jchimpo138/ear-system/research/board images/ip5310_front_components.jpg

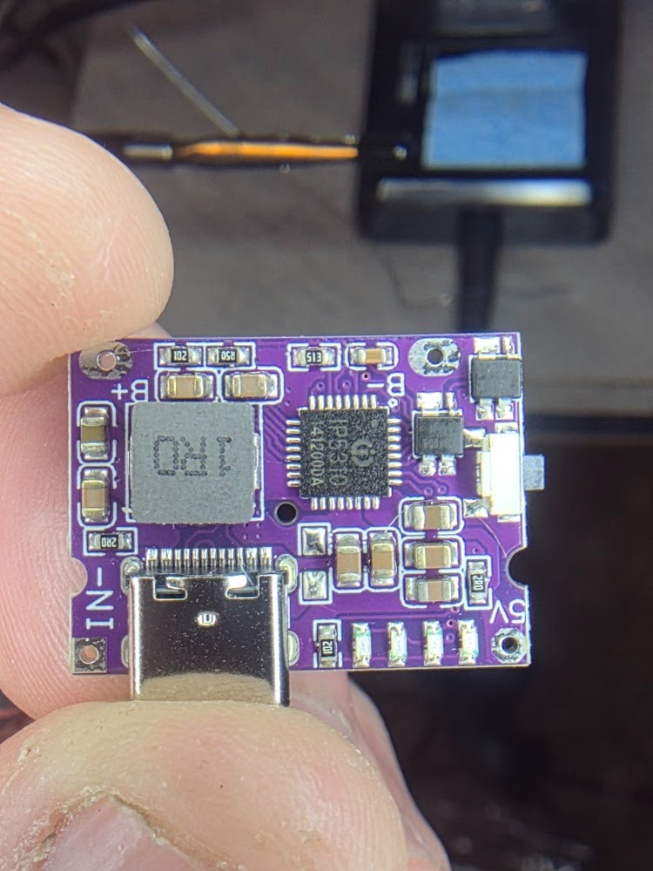
research/board images/ip5310_front_components.jpg
