jchimpo138/ear-system/.agent/rules/01-backlog-scope.md

---
trigger: always_on
---

---
trigger: always_on
description: Scope enforcement to keep focus on MVP and isolate backlog
---

# Scope & Backlog Rules

**CRITICAL SCOPE DIRECTIVE:**
1. **MVP Focus Only:** Work strictly on the current foundational/MVP requirements unless directed otherwise.
2. **Backlog Isolation:** The contents of `backlog.md` are exclusively for future roadmap planning. 
3. **NEVER IMPLEMENT BACKLOG CODE:** NEVER write, refactor, or stub code for features listed in `backlog.md` unless the active prompt explicitly instructs to pull a specific item out of the backlog.
