jchimpo138/ear-system/research/board images/FZ5vfDEWQAIqXjY.jpg

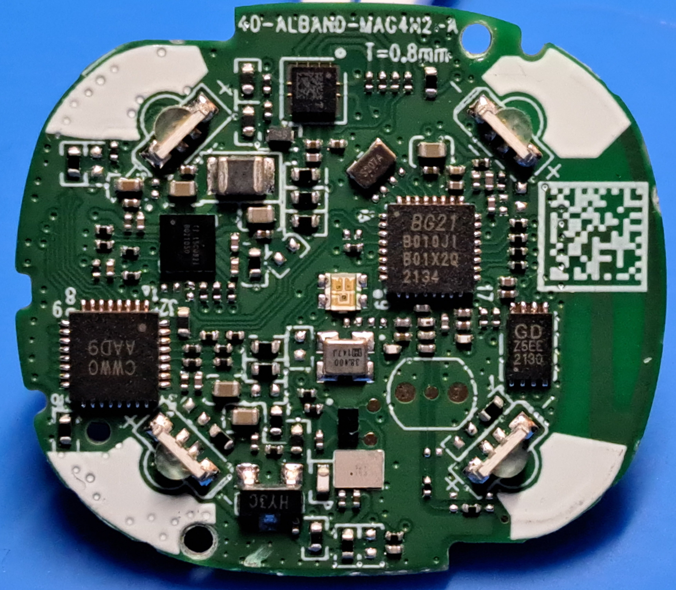
research/board images/FZ5vfDEWQAIqXjY.jpg
