jchimpo138/ear-system/research/board images/FZ5vfszXoAICueY.jpg

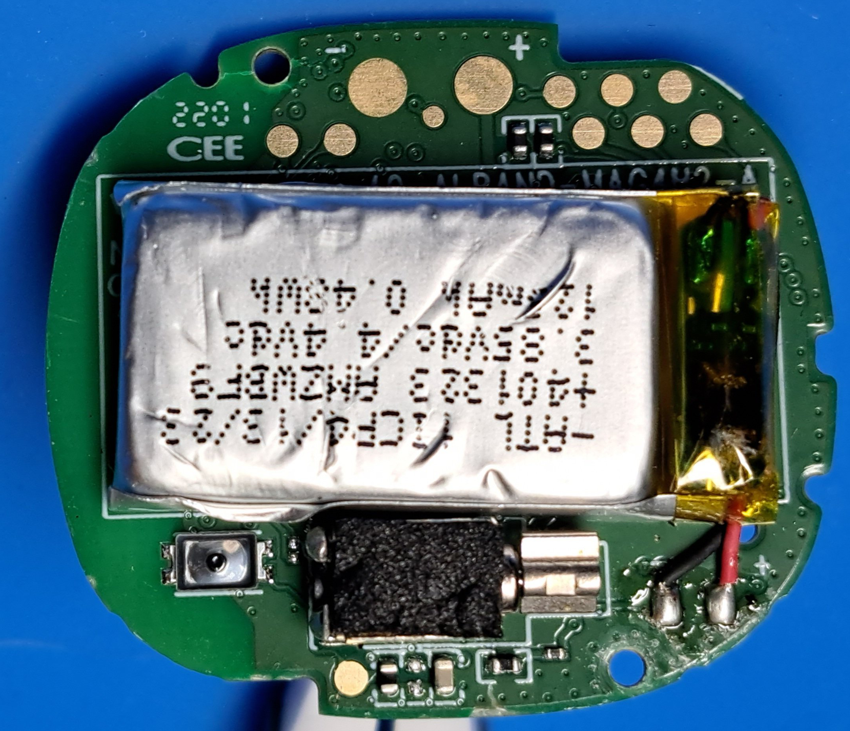
research/board images/FZ5vfszXoAICueY.jpg
