jchimpo138/ear-system/research/board images/FZ8nvv1XEAYfaYP.jpg

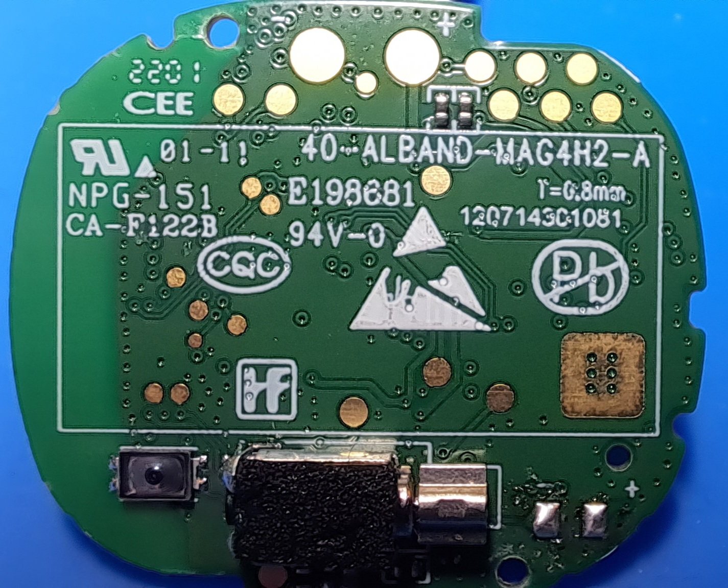
research/board images/FZ8nvv1XEAYfaYP.jpg
