jchimpo138/ear-system/research/board images/FZ8nvXFXoAEG2Y3.jpg

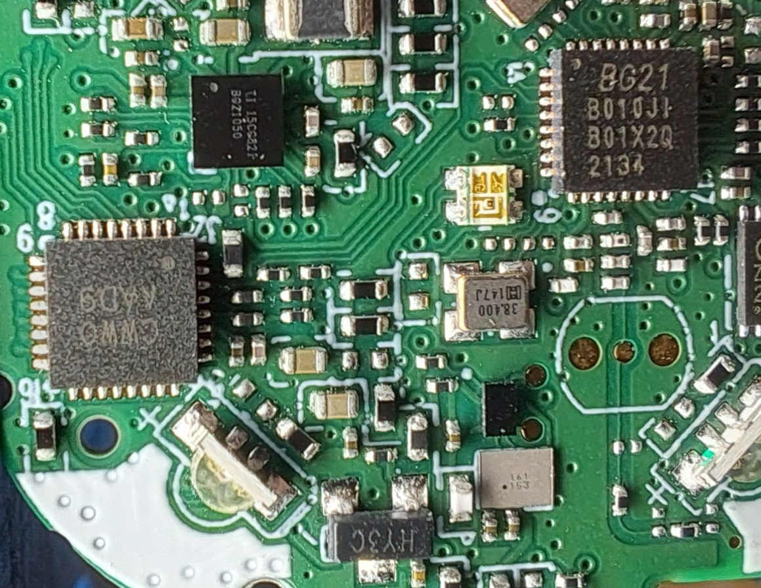
research/board images/FZ8nvXFXoAEG2Y3.jpg
