jchimpo138/ear-system/research/board images/ip5310_back_pads.jpg

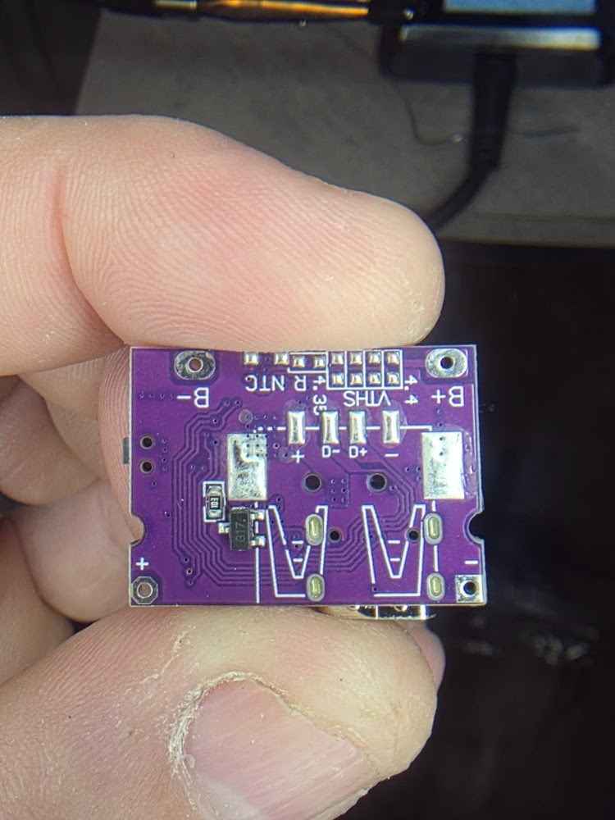
research/board images/ip5310_back_pads.jpg
