jchimpo138/ear-system/research/promicro nrf52843 v1940.jpg

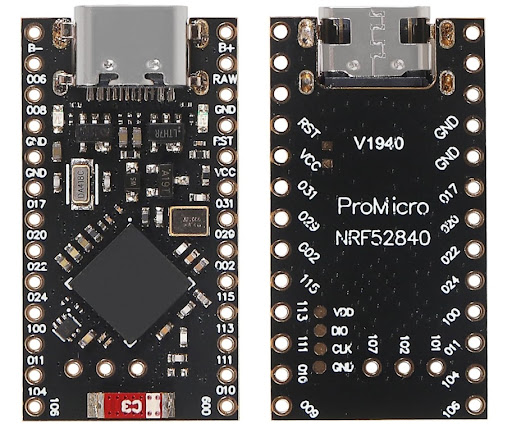
research/promicro nrf52843 v1940.jpg
