jchimpo138/ear-system/research/thor 503450 battery.png

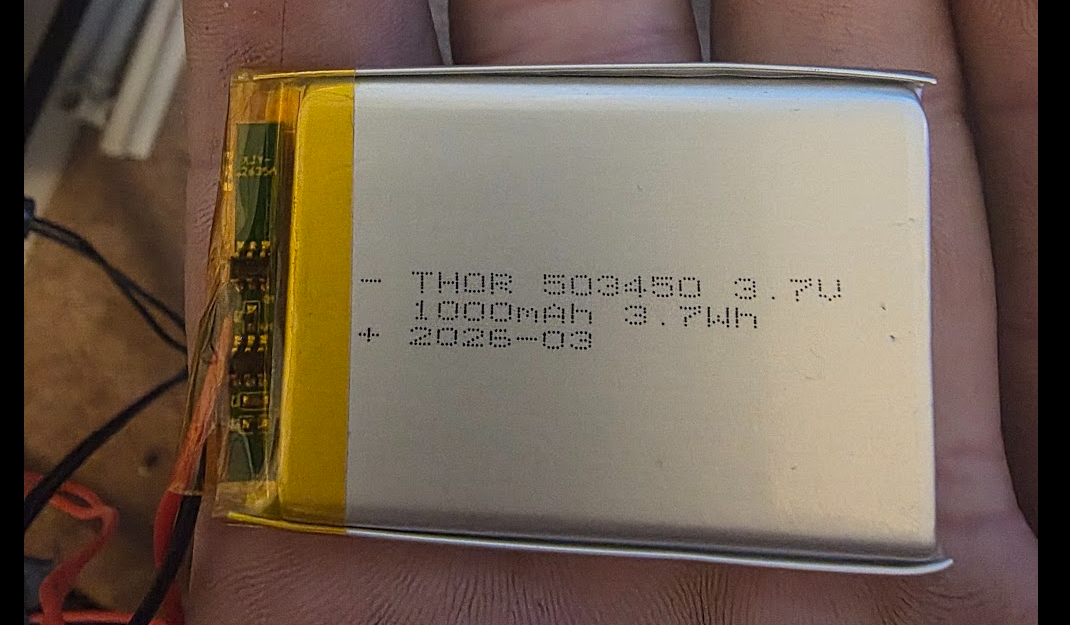
research/thor 503450 battery.png
