jchimpo138/ear-system/research/tp5100 in hand2.jpg

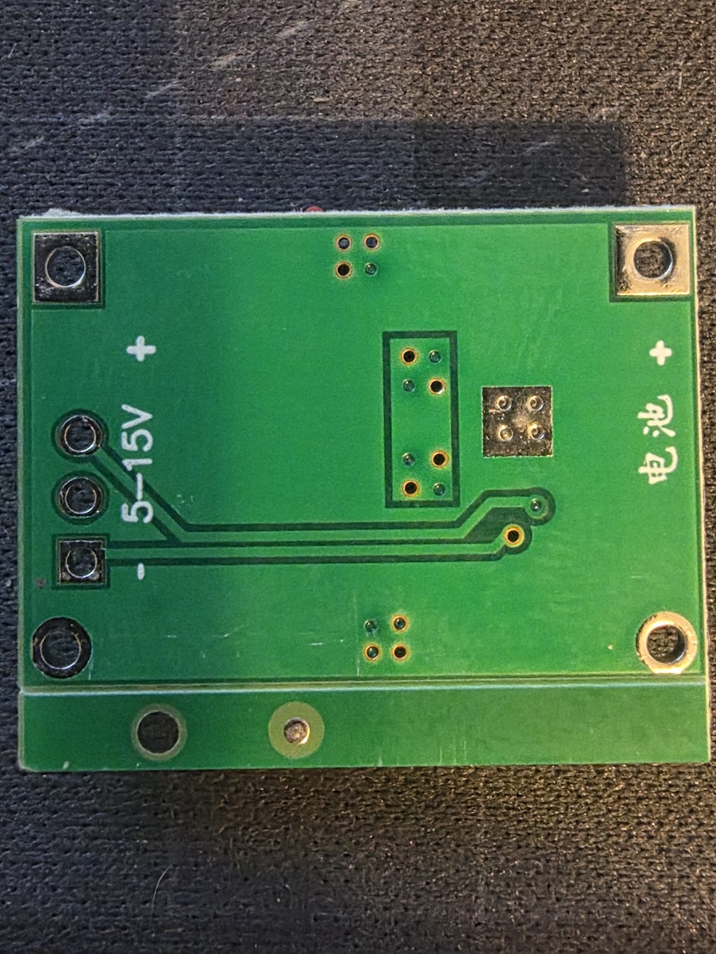
research/tp5100 in hand2.jpg
