jchimpo138/ear-system/research/tp5100 in hand.jpg

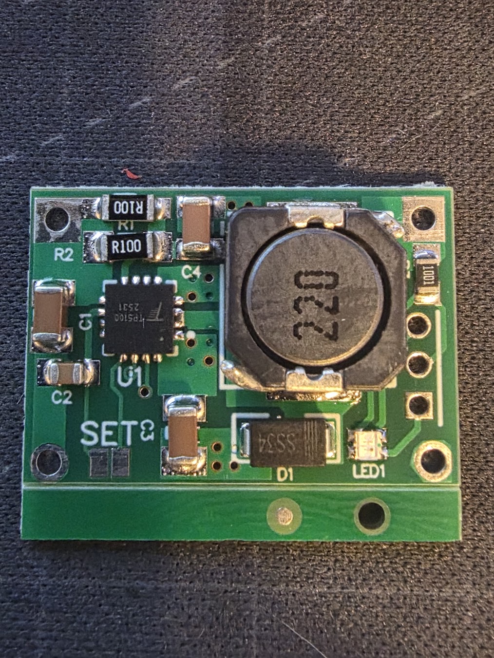
research/tp5100 in hand.jpg
