jchimpo138/ear-system/research/tp5100.jpg

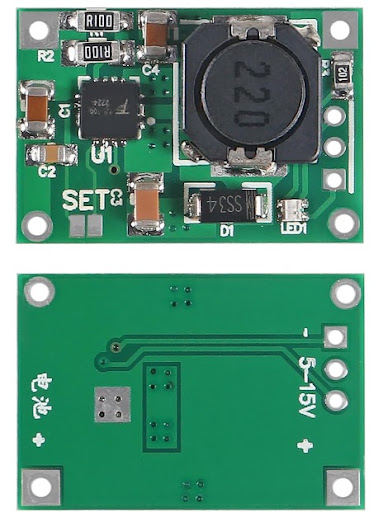
research/tp5100.jpg
