jchimpo138/ear-system/research/usb breakout.jpg

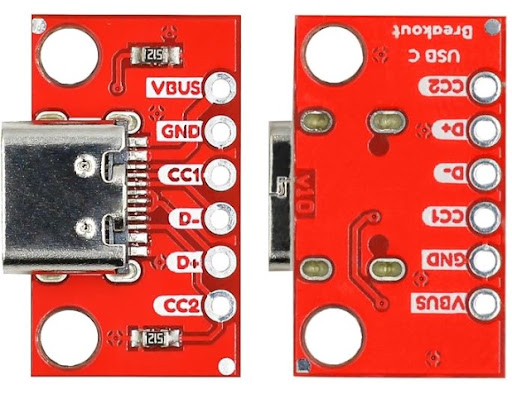
research/usb breakout.jpg
