jchimpo138/ear-system/hardware_v2_pcb/Sketch1.dxf

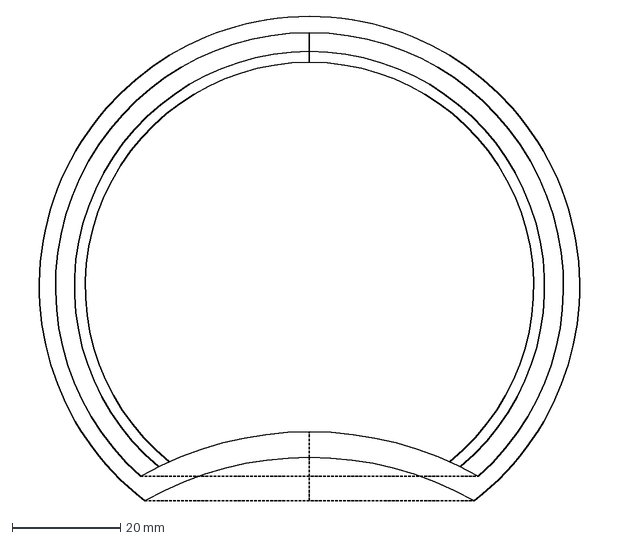
[picture p17: CAD file, 2026-08-10]
hardware_v2_pcb/Sketch1.dxf
108.5 x 89.6 mm
