jchimpo138/ear-system/hardware_v2_pcb/board shape.dxf

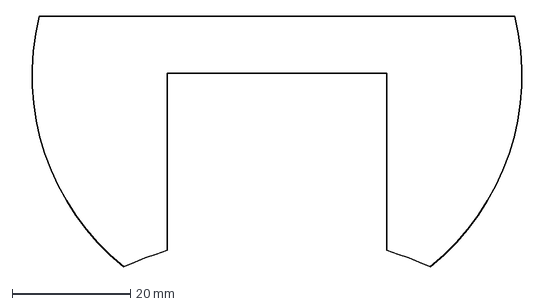
[picture p18: CAD file, 2026-08-10]
hardware_v2_pcb/board shape.dxf
88.4 x 42.4 mm
