jchimpo138/ear-system/research/board images/3d_print_prototype_fitment_1.jpg

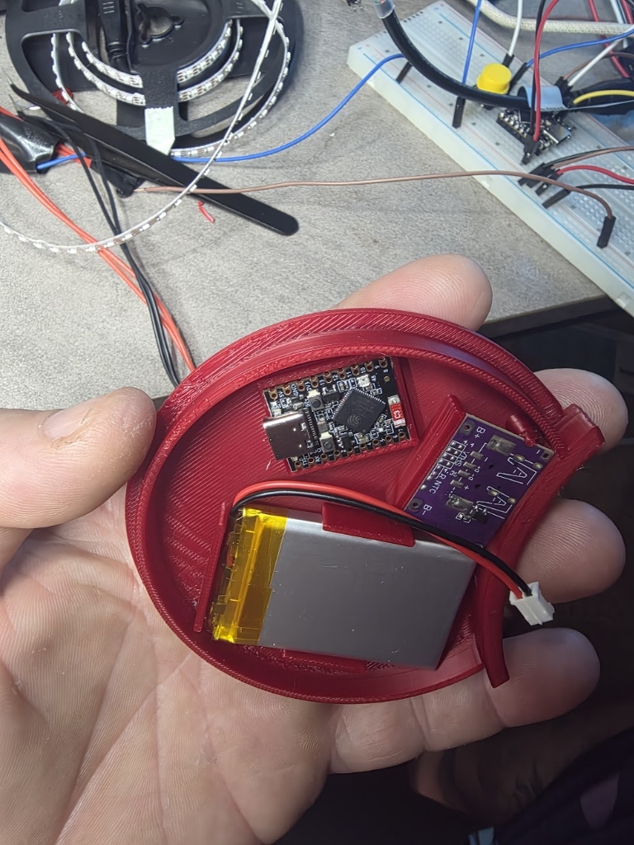
research/board images/3d_print_prototype_fitment_1.jpg
