jchimpo138/ear-system/hardware_v2_pcb/ear_receiver_v2.pdf

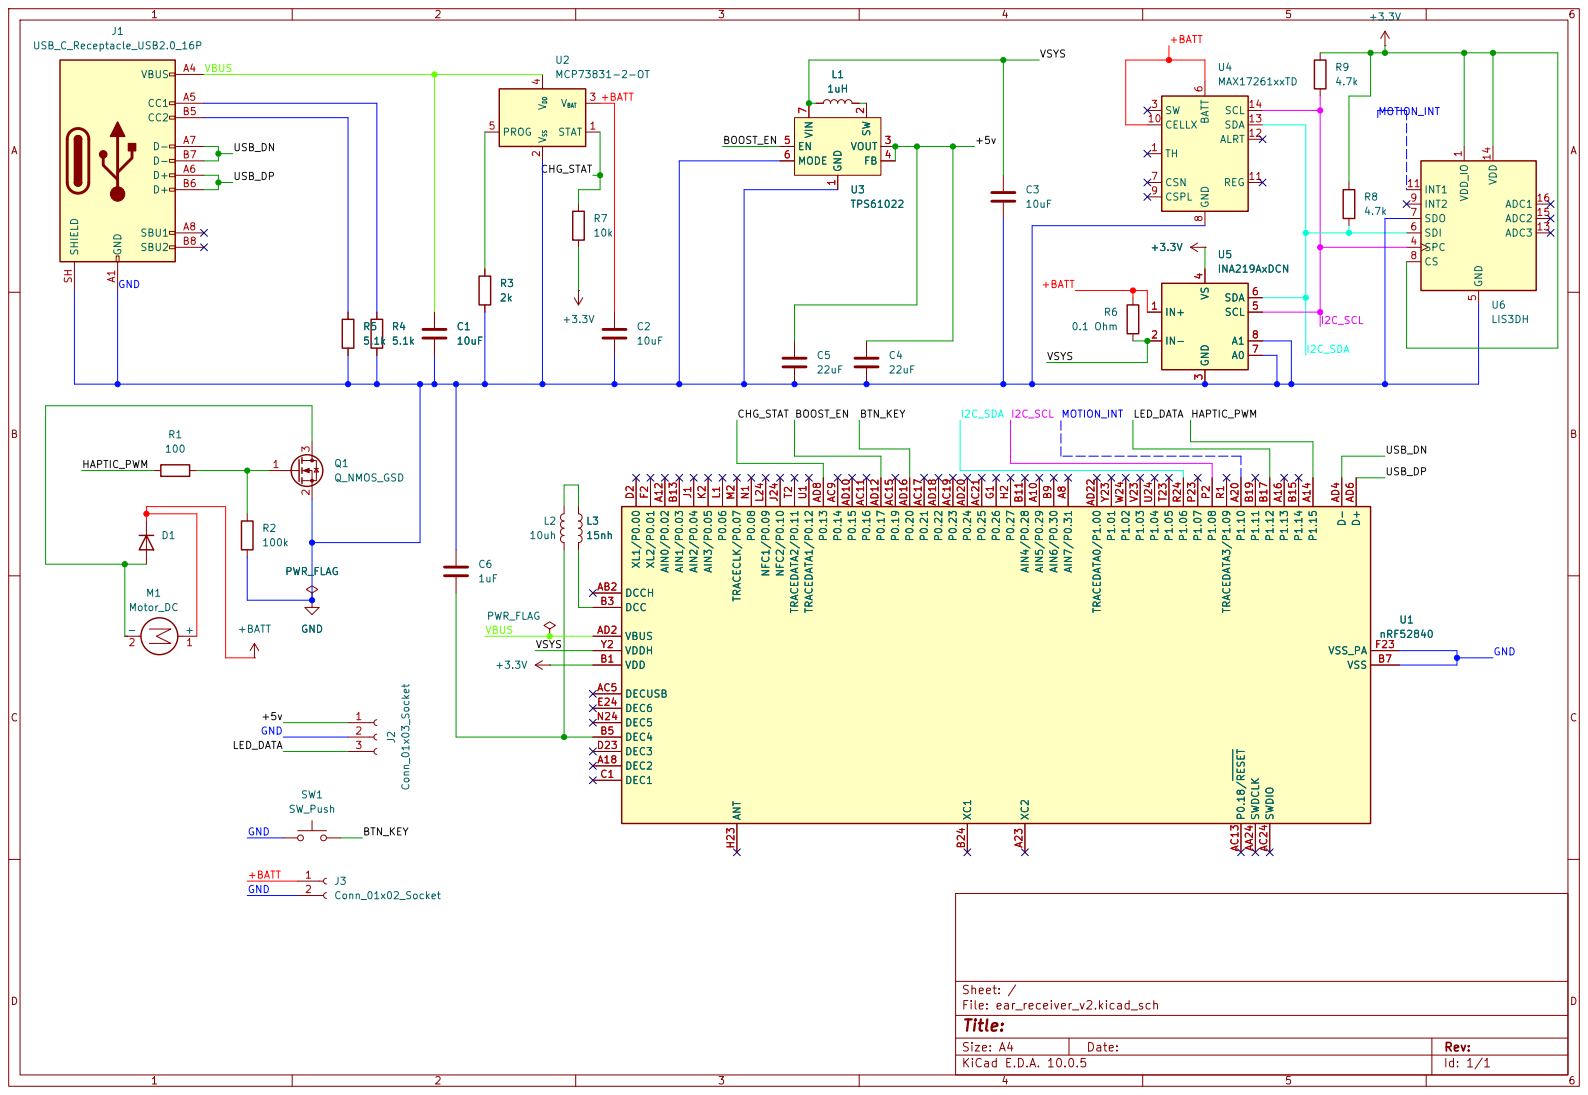
[picture p20: page 1]

Size: A4 | Rev:
KiCad E.D.A. 10.0.5 | Id: 1/1
