jchimpo138/ear-system/(list of files, drawings)

Other design files:
hardware_v2_pcb/ear_receiver_v2.1.dsn
hardware_v2_pcb/ear_receiver_v2.2.dsn
hardware_v2_pcb/ear_receiver_v2.dsn
hardware_v2_pcb/ear_receiver_v2e.2.dsn
