jchimpo138/ear-system/hardware_v2_pcb/_restore_backup_2026-07-28T02-46-58-895/ear_receiver_v2.kicad_pcb

## KiCad design hardware_v2_pcb/_restore_backup_2026-07-28T02-46-58-895/ear_receiver_v2.kicad_pcb (2026-08-10)

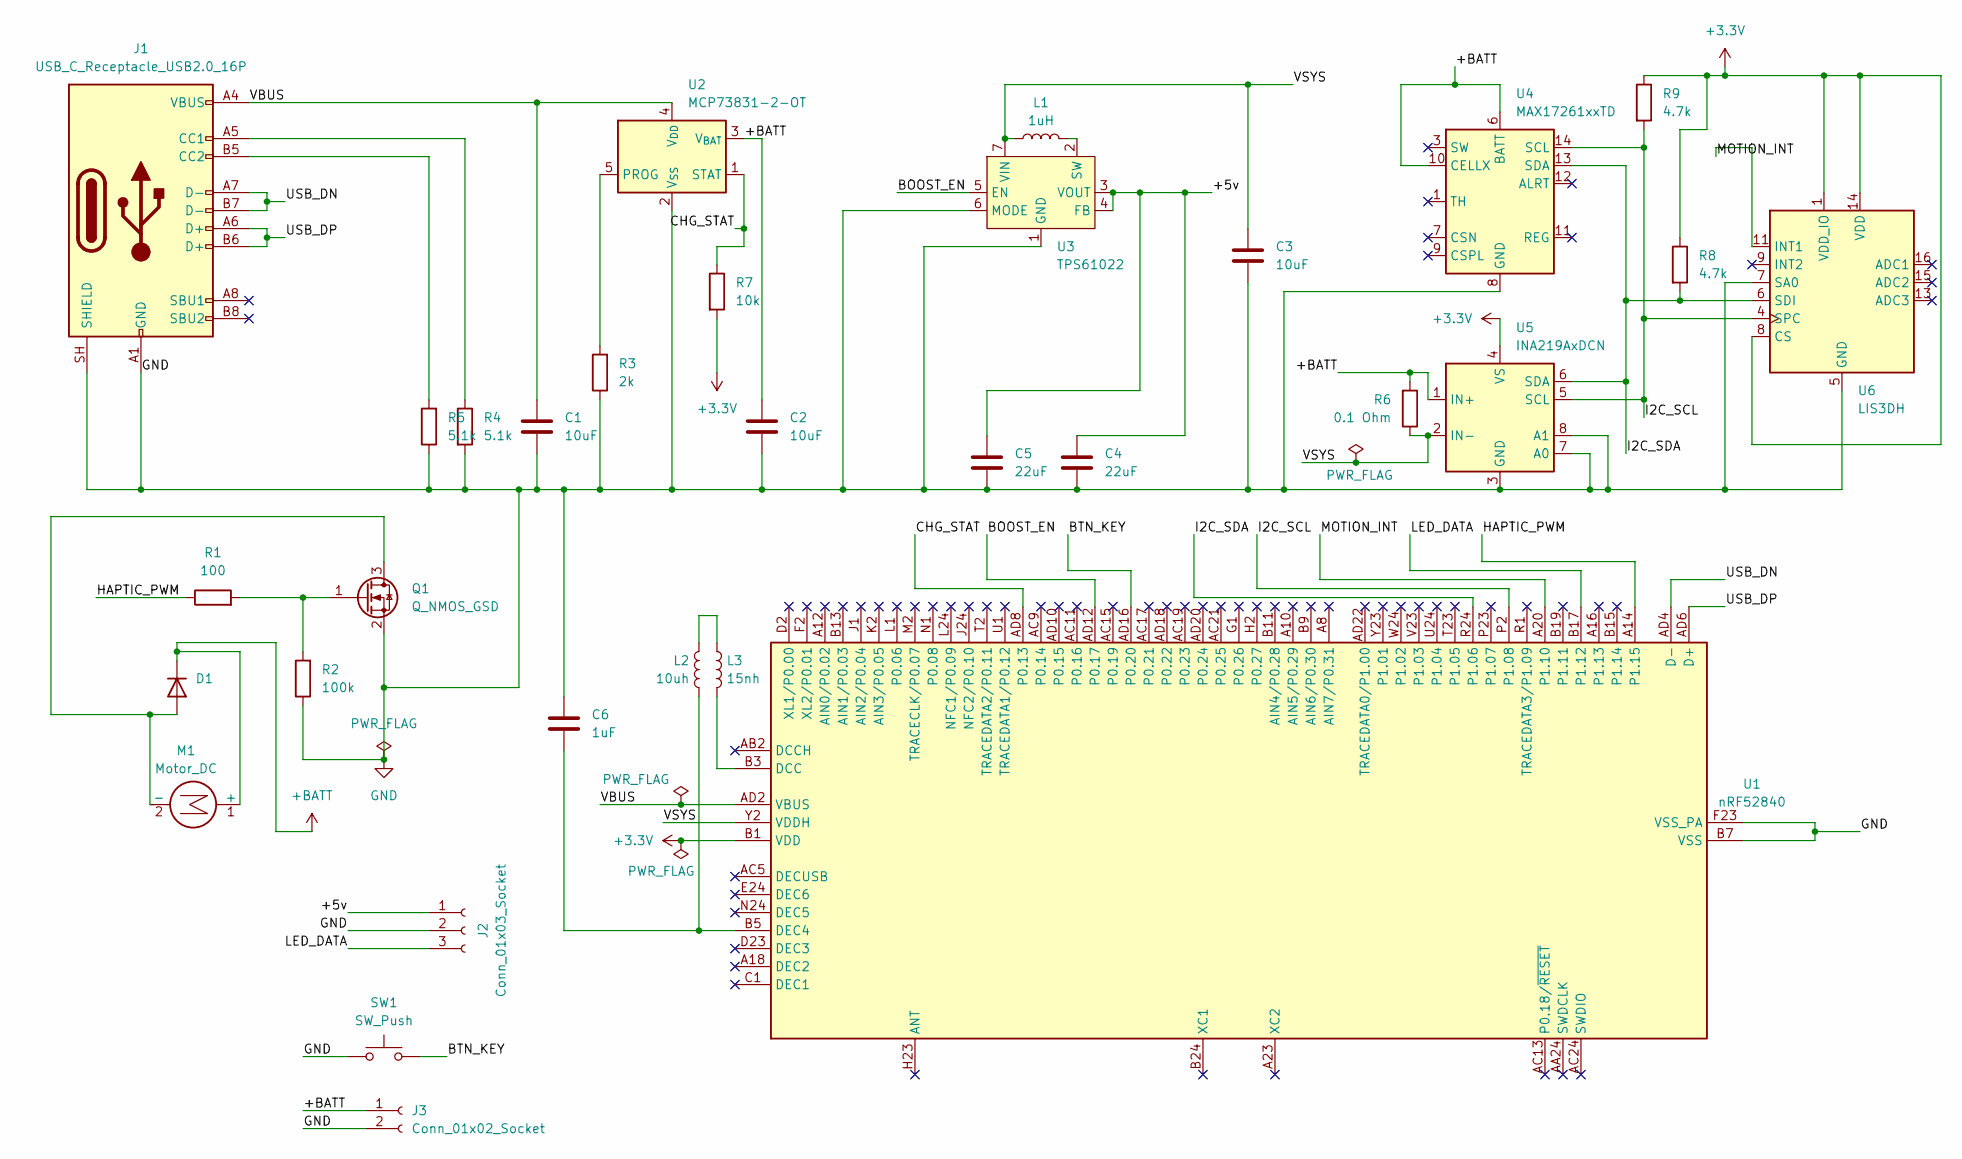
[picture p21: schematic ear_receiver_v2.kicad_sch]

Parts:
C1, C2, C3: 10uF; C_0603_1608Metric
C4, C5: 22uF; C_0603_1608Metric
C6: 1uF; C_0603_1608Metric
D1: 1N4148W; D_SOD-123
J1: USB_C_Receptacle_USB2.0_16P; USB_C_Receptacle_GCT_USB4105-xx-A_16P_TopMnt_Horizontal
J2: Conn_01x03_Socket; JST_PH_S3B-PH-K_1x03_P2.00mm_Horizontal
J3: Conn_01x02_Socket; JST_PH_S2B-PH-K_1x02_P2.00mm_Horizontal
L1: 1uH; L_0603_1608Metric
L2: 10uh; L_0402_1005Metric
L3: 15nh; L_0402_1005Metric
M1: Motor_DC; PinHeader_1x02_P2.54mm_Vertical
Q1: Q_NMOS_GSD; SOT-23
R1: 100; R_0603_1608Metric
R2: 100k; R_0603_1608Metric
R3: 2k; R_0603_1608Metric
R4, R5: 5.1k; R_0603_1608Metric
R6: 0.1 Ohm; R_1206_3216Metric
R7: 10k; R_0603_1608Metric
R8, R9: 4.7k; R_0603_1608Metric
SW1: SW_Push; SW_SPST_B3U-3000P-B
U1: nRF52840; Nordic_AQFN-73-1EP_7x7mm_P0.5mm
U2: MCP73831-2-OT; SOT-23-5
U3: TPS61022; Texas_RWU0007A_VQFN-7_2x2mm_P0.5mm
U4: MAX17261xxTD; TDFN-14-1EP_3x3mm_P0.4mm_EP1.78x2.35mm
U5: INA219AxDCN; SOT-23-8
U6: LIS3DH; LGA-16_3x3mm_P0.5mm_LayoutBorder3x5y

Connections:
+3.3V: R7.2, R8.1, R9.1, U1.A22 (VDD), U1.AD14 (VDD), U1.AD23 (VDD), U1.B1 (VDD), U1.W1 (VDD), U5.4 (VS), U6.1 (VDD_IO), U6.8 (CS), U6.14 (VDD)
+BATT: C2.2, D1.1 (K), J3.1, M1.1 (+), R6.2, U2.3 (V_{BAT}), U4.6 (BATT), U4.10 (CELLX), U5.1 (IN+)
/+5v: C4.1, C5.1, J2.1, U3.3 (VOUT), U3.4 (FB)
/BOOST_EN: U1.AD12 (P0.17), U3.5 (EN)
/BTN_KEY: SW1.2, U1.AD16 (P0.20)
/CHG_STAT: R7.1, U1.AD8 (P0.13), U2.1 (STAT)
/HAPTIC_PWM: R1.1, U1.A14 (P1.15)
/I2C_SCL: R9.2, U1.P2 (P1.08), U4.14 (SCL), U5.5 (SCL), U6.4 (SPC)
/I2C_SDA: R8.2, U1.R24 (P1.06), U4.13 (SDA), U5.6 (SDA), U6.6 (SDI)
/LED_DATA: J2.3, U1.B17 (P1.12)
/MOTION_INT: U1.A20 (P1.10), U6.11 (INT1)
/USB_DN: J1.A7 (D-), J1.B7 (D-), U1.AD4 (D-)
/USB_DP: J1.A6 (D+), J1.B6 (D+), U1.AD6 (D+)
/VBUS: C1.2, J1.A4 (VBUS), J1.A9 (VBUS), J1.B4 (VBUS), J1.B9 (VBUS), U1.AD2 (VBUS), U2.4 (V_{DD})
/VSYS: C3.1, L1.1, R6.1, U1.Y2 (VDDH), U3.7 (VIN), U5.2 (IN-)
GND: C1.1, C2.1, C3.2, C4.2, C5.2, C6.1, J1.A1 (GND), J1.A12 (GND), J1.B1 (GND), J1.B12 (GND), J1.SH (SHIELD), J2.2, J3.2, Q1.2 (S), R2.1, R3.1, R4.2, R5.1, SW1.1, U1.B7 (VSS), U1.EP (VSS), U1.F23 (VSS_PA), U2.2 (V_{SS}), U3.1 (GND), U3.6 (MODE), U4.8 (GND), U4.15 (GND), U5.3 (GND), U5.7 (A0), U5.8 (A1), U6.5 (GND), U6.7 (SA0), U6.10 (GND), U6.12 (GND)
unnamed: D1.2 (A), M1.2 (-), Q1.3 (D)
unnamed: J1.A5 (CC1), R4.1
unnamed: J1.B5 (CC2), R5.2
unnamed: L2.1, L3.1
unnamed: Q1.1 (G), R1.2, R2.2
unnamed: L3.2, U1.B3 (DCC)
unnamed: C6.2, L2.2, U1.B5 (DEC4)
unnamed: R3.2, U2.5 (PROG)
unnamed: L1.2, U3.2 (SW)

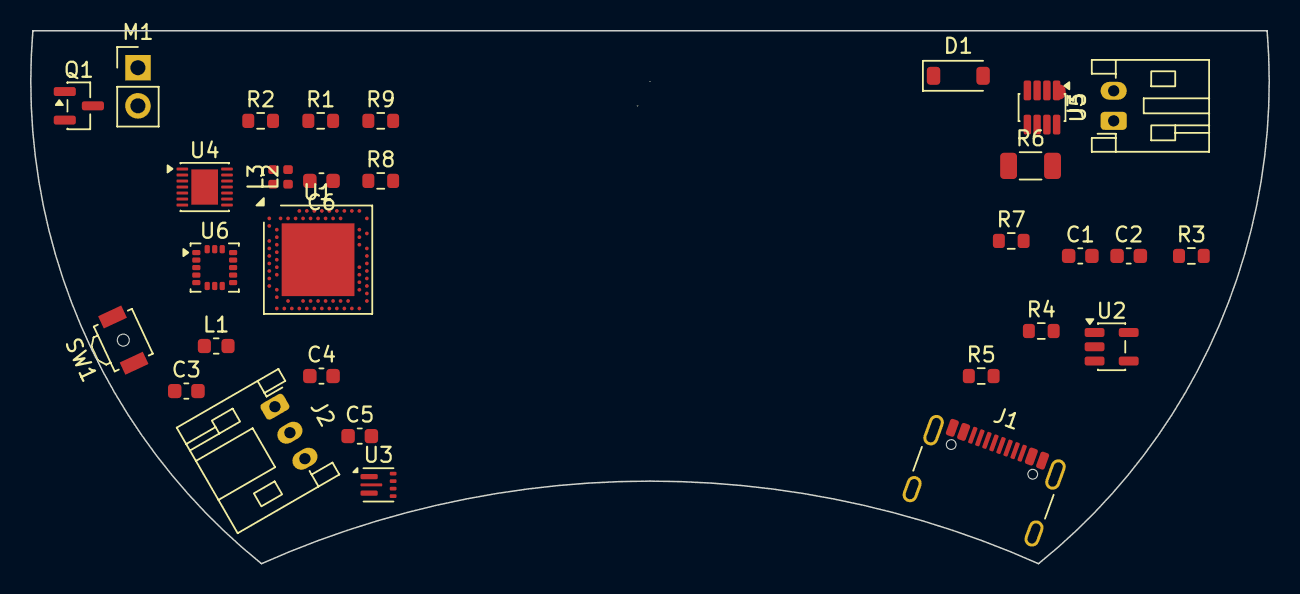
[picture p22: board ear_receiver_v2.kicad_pcb from above]

Board: 2 copper layers, 82.5 x 35.5 mm, 31 parts (0 on the bottom side), 25 nets.
