jchimpo138/ear-system/(commit log)

2026-07-25 docs: add user IP5310 board reference photos to research
2026-07-25 docs: add IP5310 LED pinhole visibility enclosure note to backlog
2026-07-25 docs: detail battery voltage monitoring in backlog
2026-07-25 feat: integrate LIS3DSH motion sensor I2C driver and shake trigger
2026-07-25 docs: add battery optimization roadmap to backlog
2026-07-26 docs: defer motion sensor and haptic motor hardware to v1.1 for MVP CAD simplicity
2026-07-27 docs: add 3mm LED wire pass-through opening to Fusion 360 checklist
2026-07-27 docs: add battery retention clips to Fusion 360 CAD checklist
2026-07-27 docs: add ESP32 tray extension to Fusion 360 CAD checklist
2026-07-27 docs: add ESP holder left-shift clearance to Fusion 360 CAD checklist
2026-07-27 docs: add IP5310 battery wire path to Fusion 360 CAD checklist
2026-07-27 docs: update backlog with vibration module CAD dimensions
2026-07-27 docs: add physical 3D printed prototype assembly photos
2026-07-27 docs: add v2.0 custom PCB silicon chipset spec list to backlog
2026-07-27 rule: enforce 1C maximum LiPo charging safety limit rule
2026-07-27 docs: update v2.0 custom PCB spec with MCP73831 / TI BQ25606 500mA 1C charger limit
2026-07-27 docs: add v2.0 KiCad custom PCB schematic and netlist reference guide
2026-07-27 docs: update KiCad reference to KiCad 10
2026-08-10 sync: update ears receiver firmware and project files
    [Sketch1.dxf, board shape.dxf, ear_receiver_v2.1.dsn, ear_receiver_v2.2.dsn, ear_receiver_v2.dsn, ear_receiver_v2.kicad_pcb, ear_receiver_v2.kicad_sch, ear_receiver_v2e.2.dsn]
2026-08-26 feat: bring up XIAO nRF52840 Sense ears firmware end-to-end
    Migrates the ears receiver firmware from the nicenano dev board target to
    the actual Seeed XIAO nRF52840 Sense, and brings the full hardware stack up
    and bench-verified: FET1 firmware-gated LED rail (true zero-drain idle),
    FET2's passive per-ear presence gate (documented and verified in CLAUDE.md),
    NeoPixel/SK6812 RGBW output via Adafruit_NeoPixel (FastLED's nRF52 clockless
    driver is confirmed broken on this board), manual mode button, PWM-derated
    haptic motor, and the onboard battery-voltage ADC with a charge-safety-aware
    read path and a percentage curve calibrated to the actual cell's discharge
    data.
    Also adds CC03 wake-ping adap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
    [main.cpp]
2026-08-26 fix: correct Disney show timing/offsets and add palette cross-fade
    Reads the protocol's real Timing Byte instead of a hardcoded 4s display
    duration, fixes byte-offset bugs in the 0x08/0x09 handlers, and adds the
    missing 0x11 Palette Cross-Fade handler (two-zone oscillating swap,
    matching real MagicBand+ behavior, with a steepened blend curve and
    per-effect intensity boost so the fade reads clearly on the strip).
    [main.cpp]
2026-08-27 fix: convert blocking show animations to non-blocking rendering
    Wand Cast (0xC1), Statue (0xC4), Wave Pulse (0x12), and Strobe Pulse
    (0x0C/0x0E) previously ran their own delay()-based blocking loops inside
    executeDisneyMicrocode(), stalling BLE scanning, button/haptic handling,
    and rail-gating for the animation's full duration. Rewritten to render one
    elapsed-time-throttled frame per loop() pass, matching the pattern already
    used by the 0x11 cross-fade -- confirmed via a real capture that a second
    BLE command sent 5s into an active 20s Wave Pulse show is now picked up
    immediately instead of being missed. Wave Pulse's own hardcoded 6s cap is
    also removed in favor of the real decoded Timing By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
    [main.cpp]
2026-08-28 feat: implement Family 3 E9 10 park-show renderer
    Reverse-engineered the unwrapped E9/EA "park infrastructure" packet
    format end-to-end against a real MagicBand+ across dozens of crafted
    test payloads, and implemented it in the ears firmware:
    - Family 3 detection (E9/EA header 2 bytes earlier than Family 1's
    wrapped layout) now decodes E9 10 instead of just logging it.
    - Confirmed two distinct rendering families gated by byte 7's own Mode
    field: Mode 5-7 renders 5 independently-addressable LED-color bytes
    (static or a rotating chase depending on a PatternID byte, direction
    from its low bit); Mode 0-4 (including the real captured default) is
    a single-color mostly-lit ring with a sw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
2026-08-28 docs: correct E9 09 LED order and document fiber-optic quadrant plan
    Bench-confirmed against a real MagicBand+ (same one-at-a-time isolation
    method used for E9 10 earlier) that E9 09's color-slot order is Center,
    NE, SE, SW, NW -- identical to E9 10's order, not the "TL, BL, BR, TR,
    Center" labeling from the emcot.txt community wiki that the Adafruit
    reference project also copied uncritically. Corrected in PROTOCOL.md and
    in main.cpp's E9 09 handler comment (no functional code change needed,
    since the firmware already just fills 5 sequential bytes into 5
    sequential strip zones without depending on the label).
    Also documents a planned hardware upgrade in CLAUDE.md: 4 fiber-optic-fed
    LEDs per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
    [main.cpp]
2026-08-28 docs: add E9 13 findings and EA 14 no-reaction note to PROTOCOL.md
    E9 13 (unwrapped) confirmed to share E9 10's color layout and Timing
    Byte formula. Also documents: TIME_VAL=0 duration anomaly, FADE_CODE
    having no observable effect on this animation, and a consistent ~4.5s
    hold-then-cut tail at the end of every show regardless of duration.
    EA 14 noted as producing no reaction at all when replayed against a
    real band, unlike every E9 10/E9 13 example tested.
2026-08-28 feat: add E9 13 renderer, fix NE-controls-chaser-color model
    Wired E9 13 (unwrapped) into the same E9 10 decode/render path in
    main.cpp, since bench testing confirmed they share byte layout, Timing
    Byte formula, and render behavior. Along the way, testing E9 13 against
    a real MagicBand+ (with a non-Off NE byte, unlike E9 10's real capture)
    revealed the Mode 0-4 "background+chaser" render was subtly wrong: NE's
    color controls the chaser, not a fixed dark gap -- E9 10's own real
    capture just happens to have NE=Off, which coincidentally made the
    chaser look like a dark gap and hid the real mechanism through two
    prior correction rounds. Fixed to read the chaser color from
    showColorsPark5[1] live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
    [main.cpp]
2026-08-28 feat: add E9 14 flicker renderer, fix receivedCommandType collision
    E9 14 (wrapped format) confirmed to share the same Center/NE two-color
    model as E9 10/13's background+chaser render, but animates much faster
    and less predictably -- implemented as a fast 5-zone random flicker
    instead of reusing the steady sweep renderer, which looked visibly
    wrong for this command.
    Also fixes a real collision bug found while wiring this up: the
    wrapped-format generic fallback left receivedCommandType at the raw
    showCmd value instead of resetting it, so a wrapped packet whose
    showCmd happened to literally be 0x10 or 0x13 (both real, confirmed
    opcodes without their own wrapped-format handler) would fall thro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
    [main.cpp]
2026-08-28 fix: render E9 0C as a rainbow instead of a white strobe
    E9 0C ("Animation Codes", includes "Taste the Rainbow") was lumped in
    with E9 0E's genuine strobe behavior, showing a white flash instead of
    anything rainbow-like -- reported as visibly wrong on real hardware.
    E9 0C's "Taste the Rainbow" bytes turn out to be a firmware-baked
    animation program on the real band, not real palette data: decoding
    them via the standard formula gives a scrambled non-rainbow sequence,
    same conclusion research/BLE_Beacon_Ears reached independently. Fixed
    by detecting the known signature and rendering a discrete 6-color-band
    sweep (adapted from that project's own approach for this exact
    signature -- tried a smo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
    [main.cpp]
2026-08-28 feat: disambiguate E9 0C's baked animations, use real white LED
    Blink White and Taste the Rainbow share an identical 12-byte signature
    in their real captures, differing only in the last byte (0x95 vs the
    real 0xB0) -- previously both misfired as Rainbow since only the shared
    prefix was checked. Added the tail-byte disambiguation (same approach
    Adafruit's reference renderer uses) plus detection for the separate
    Orange Blink signature.
    Both Blink White and Orange Blink are visually just the existing E9 0E
    strobe in a different color, so the strobe renderer was generalized to
    use showR1/G1/B1 instead of hardcoded white and reused for both,
    instead of writing new render logic.
    Also fixes white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
    [main.cpp]
2026-08-28 fix: correct E9 0C blink rate and Orange Blink's runaway duration
    Confirmed live against a real MagicBand+: Blink White is a much slower
    ~0.5s on/off blink, not E9 0E's fast strobe rate -- both were sharing
    one hardcoded interval since Blink White reuses the E9 0E renderer.
    Made the blink/strobe interval per-command instead.
    Also overrides Orange Blink's real captured Timing Byte, which has
    ALWAYS_ON set (an alert-style animation meant to hold indefinitely on
    the real band), to a fixed 5s duration -- indefinite hold isn't useful
    for a wearable prop, confirmed as the intended behavior by the user.
    [main.cpp]
2026-08-28 fix: E9 0B renders a white dot chase, not a static blue/white split
    The previous "Electric Blue outer ring, White center fill" behavior
    was never bench-tested -- PROTOCOL.md's documented example even used
    different tail bytes than what our own transmitter actually sends
    (which matches the real captured example in research/emcot.txt
    exactly). Confirmed live against a real MagicBand+: this command
    renders as a cluster of white LEDs chasing around the ring, dark
    otherwise. Tuned via direct comparison against the real band's
    animation (single dot -> 6-wide cluster, slightly faster step rate).
    Uses the SK6812's real white channel, consistent with the E9 0C/0E
    white-channel fix from earlier tonigh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
    [main.cpp]
2026-08-28 fix: cap ALWAYS_ON shows at 24s instead of running forever
    Confirmed live: ALWAYS_ON doesn't mean literally infinite on real
    hardware -- an E9 0E example with ALWAYS_ON set turned off after ~24s,
    not indefinitely. Firmware previously treated it as truly permanent
    (never expiring until a new command arrived), which doesn't match real
    behavior. Applied a fixed 24s cap instead; only one data point exists
    so the real duration formula for this flag isn't known yet.
    Also documents a real finding in PROTOCOL.md: E9 0E's documented
    2-color layout appears wrong -- 5 real captures all decode as the same
    5-slot Center/NE/SE/SW/NW palette used by E9 09/10/0C, matching the
    reported visuals well. Not yet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
    [main.cpp]
2026-08-28 fix: E9 0E/0B render fixes, ALWAYS_ON cap, wand cast color bug, richer statue
    E9 0E's documented 2-color strobe layout was wrong -- 5 real captures all
    decode as the same 5-slot Center/NE/SE/SW/NW palette used by E9 09/10/0C,
    matching reported visuals well. Rendered as a discrete color-wheel
    rotation, same mechanism as E9 0C's Rainbow fix, adapted from the
    Adafruit reference renderer's generic "animation" handler (research/
    BLE_Beacon_Ears) which explicitly treats E9 0B/0E/0F the same way.
    E9 0B's documented "Electric Blue outer, White center" was also never
    bench-tested (PROTOCOL.md's own example used different untested bytes
    than what our transmitter sends) -- really a 6-pixel-wide white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
    [main.cpp]
2026-08-28 fix: E9 12 offset bug, real white-channel use, non-blocking haptics, low-battery warning
    - Fix Wave Pulse (E9 12) reading the wrong payload offsets: primary color
    was actually the timing byte and secondary was never used at all.
    - Route every palette-driven render (not just the E9 0E strobe) through the
    real SK6812 white channel instead of faking white via R=G=B, including a
    pass over the manual test animations (Ignition Pulse, Meteor Chase, Cyber
    Plasma, Lightning Storm, Neon Glitch, HyperDrive).
    - Fix an out-of-bounds read: E9 0C's generic fallback could underflow its
    slot count on a short packet and wrap a uint8_t into reading way past
    showColors5's real 5 slots.
    - Replace the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
    [main.cpp]
2026-09-03 fix: enable DC-DC + disable blue LED, add boot diagnostics, lower brightness
    - Enable the nRF52840's DC-DC regulator (never turned on before) and
    disable Bluefruit's continuous blue "connection" LED blink -- together
    these were the largest contributors to an idle current floor well above
    what the power budget assumed (measured ~630-1000uA -> ~390uA on the
    XIAO alone).
    - Explicitly power down the onboard IMU (LSM6DS3TR-C) and PDM mic power
    pins at boot -- neither is used by this build and both were left
    floating with an unknown default state.
    - Add a one-shot boot print of the live bootloader version/BSP version/MCU
    serial number (dbgPrintVersion()), and a periodic Serial status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
    [main.cpp]
